jliklik/bcit_psu/Images/BCIT_PSU_CustomPCBs.jpg

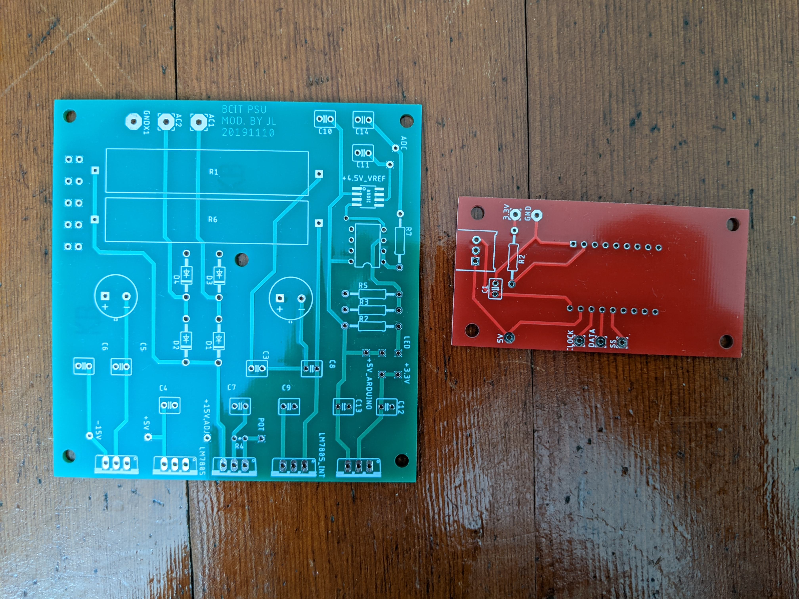
Images/BCIT_PSU_CustomPCBs.jpg
