jliklik/bcit_psu/Images/BCIT_PSU.jpg

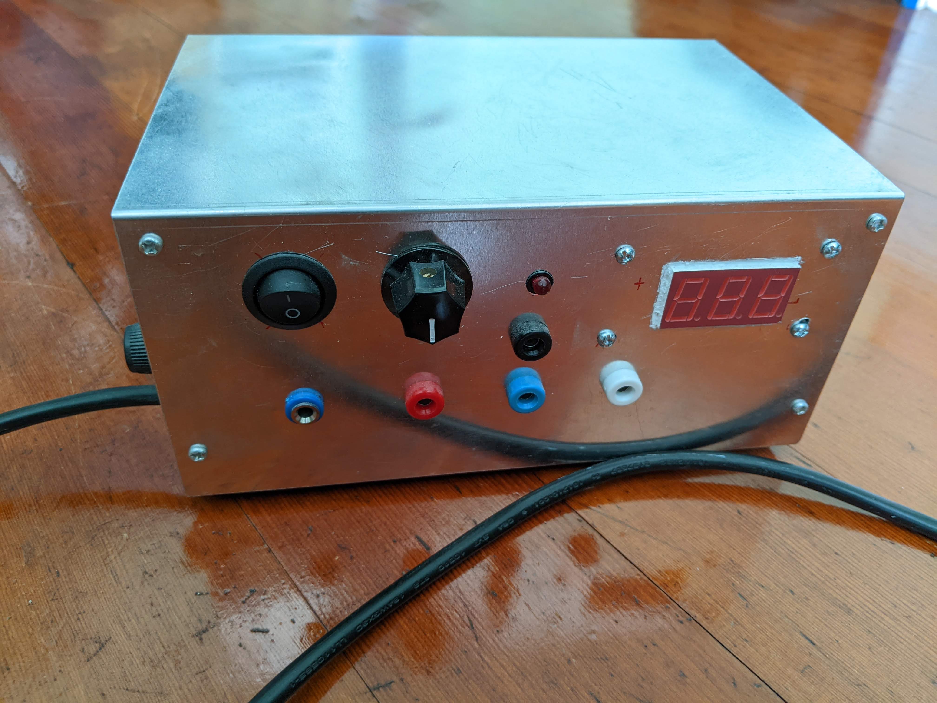
Images/BCIT_PSU.jpg
