jliklik/bcit_psu/LEDDisplay_Schematic.pdf

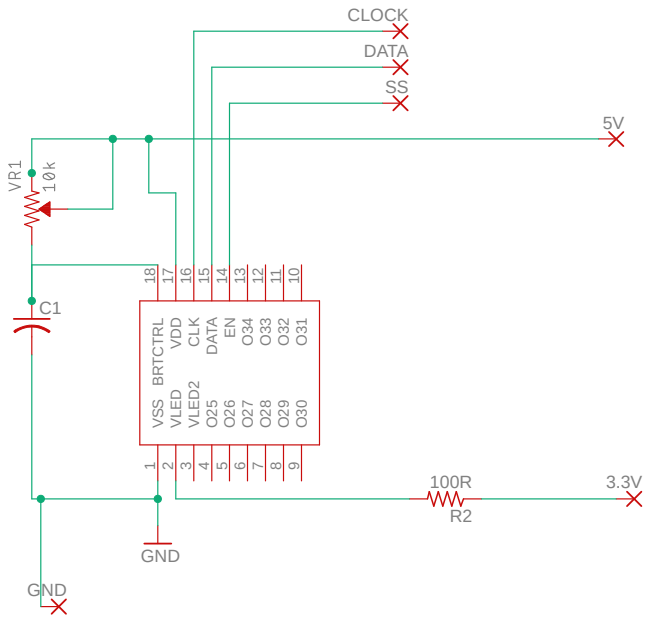
[picture p3: figure]
GND; 100R VSS; 1 VLED; 2 VLED2; CLOCK; DATA

2020-06-14 4:20 PM C:\Users\jlikl\Documents\EAGLE\projects\LTM 8522HR Board\LTM8522HR.sch (Sheet: 1/1)

### 9 BRTCTRL 18 VDD 17 CLK 16 DATA 15 EN 14 O34 13 O33 12 O32 11 O31 10
