jliklik/bcit_psu/BCIT PSU Doc/04B-PCB Artwork.pdf

ELEX 1102 | Electronic Fabrication Tools and Techniques
Product: DC Power Supply | Author: Instructor
Revision: B | PCB Artwork

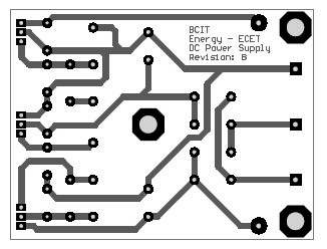
[picture p4: figure]

Date: 20160315 | Page: 1 of 1

Board dimensions: 3.30in x 2.50in
