jliklik/bcit_psu/Reference/ADC_circuit.png

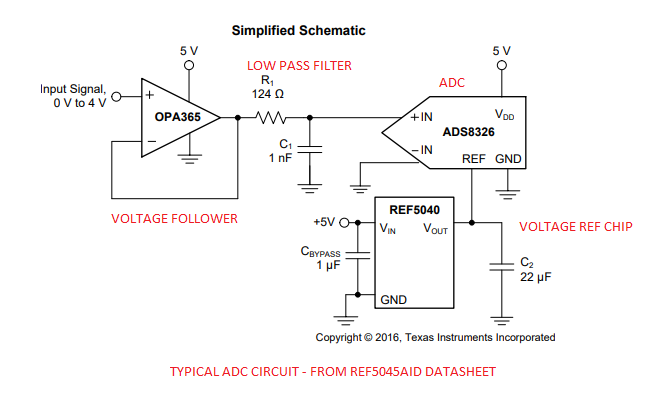
Reference/ADC_circuit.png
