jliklik/bcit_psu/BCIT PSU Doc/03B-Parts List.pdf

ELEX 1102 | Electronic Fabrication Tools and Techniques
Product: DC Power Supply | Author: Instructor
Revision: B | Parts List
Date: 20160602 | Page: 1 of 2

## Electrical

Ref Des | Description | Manufacturer | Part Number | Qty
C1,C2 | Capacitor, Al electrolytic, Radial, 3300uF, 20%, 25V | Nichicon | UVR1E332MHD (http://www.digikey.ca/product-search/en?keywords=493-1067-nd) | 2
C3,C5 | Capacitor, Al electrolytic, Radial, 0.1uF, 20%, 50V | Nichicon | UVR1H0R1MDD (http://www.digikey.ca/product-search/en?keywords=493-1095-nd) | 2
C4,C6 | Capacitor, Al electrolytic, Radial, 1uF, 20%, 50V | Nichicon | UVR1H010MDD (http://www.digikey.ca/product-search/en?keywords=493-1099-nd) | 2
C7 | Capacitor, Al electrolytic, Radial, 2.2uF, 20%, 50V | Nichicon | UVR1H2R2MDD (http://www.digikey.ca/product-search/en?keywords=493-1100-nd) | 1
D1,D2,D3,D4 | Diode, General purpose, DO41, 600V, 1A | Fairchild Semiconductor | 1N4005 (http://www.digikey.ca/product-search/en?keywords=1N4005FSCT-ND) | 4
D5 | Diode, Light emitting, Red, Panel Mount, 2-pin | Mode Electronics | 55-432-0 (https://www.e-sonic.com/Search.aspx?text=:%2055-432-0) | 1
F1 | Fuse, Glass, Miniature, Slow Blow, 250V, 0.375A | Bussman / Eaton | MDL-3/8 (https://www.e-sonic.com/product-detail/bussmann-eaton/mdl38.html?p=10812346) | 1
J1 | Connector, Banana, Red, Panel Mount, Solder Lug | Johnson | 108-0902-001 (https://www.e-sonic.com/product-detail/johnson-cinch-connectivity-solutions/1080902001.html?p=11276257) | 1
J2 | Connector, Banana, White, Panel Mount, Solder Lug | Johnson | 108-0901-001 (https://www.e-sonic.com/product-detail/johnson-cinch-connectivity-solutions/1080901001.html?p=11276256) | 1
J3 | Connector, Banana, Violet, Panel Mount, Solder Lug | Johnson | 108-0912-001 (https://www.e-sonic.com/product-detail/johnson-cinch-connectivity-solutions/1080912001.html?p=11276265) | 1
J4 | Connector, Banana, Black, Panel Mount, Solder Lug | Johnson | 108-0903-001 (https://www.e-sonic.com/product-detail/johnson-cinch-connectivity-solutions/1080903001.html?p=11276258) | 1
P1 | Power cord, 18AWG x 3, 1.8m, 125V, 10A | Volex | 17237-8-B1 (https://www.e-sonic.com/product-detail/volex-power-cords/172378b1.html?p=10687852) | 1
R1 | Resistor, Axial, 10R, 5%, 10W | Ohmite | 20J10RE (http://www.digikey.ca/product-detail/en/20J10RE/20J10RE-ND/822925) | 1
R2,R4 | Resistor, Axial, Carbon Film, 390R, 5%, 0.25W | Stackpole Electronics | CF14JT390R (http://www.digikey.ca/product-search/en?keywords=CF14JT390RCT-ND) | 2
R3 | Potentiometer, Linear, 5K, 20%, 0.1W, Panel Mount, Solder Lug | Mode Electronics | 62-243-0 (https://www.e-sonic.com/product-detail/mode/622430.html?p=45319501) | 1
S1 | Switch, SPST, Round, Rocker, Quick Connect, 250V, 10A | Mode Electronics | 46-100J-0 (https://www.e-sonic.com/product-detail/mode/46100j0.html?p=45319367) | 1
T1 | Transformer, Single Primary, Center tapped, 33V, 1A | Hammond | 166J33 (http://www.e-sonic.com/product-detail/hammond-canada/166j33.html?p=45469764) | 1
VR1 | Regulator, Fixed, TO220-3, LM7805, 5V, 1A | Fairchild Semiconductor | LM7805ACT (http://www.digikey.ca/product-search/en?keywords=LM7805ACT-ND) | 1
VR2 | Regulator, Adjustable, TO220-3, LM317, 1.5A | Fairchild Semiconductor | LM317TFS-ND (http://www.digikey.ca/product-search/en?keywords=LM317TFS-ND) | 1
VR3 | Regulator, Fixed, TO220-3, LM7915, -15V, 1A | Fairchild Semiconductor | LM7915CT (http://www.digikey.ca/product-search/en?keywords=LM7915CTFS-ND) | 1
- Consumable items are not included

ELEX 1102 | Electronic Fabrication Tools and Techniques
Product: DC Power Supply | Author: Instructor
Revision: B | Parts List
Date: 20160602 | Page: 2 of 2

## Mechanical

Ref Des | Description | Manufacturer | Part Number | Qty
M1 | Board, Printed circuit, DC Power Supply, Rev B | Enigma Interconnect | DC Power Supply Rev B (http://www.enigmacorp.com/) | 1
M2 | Bushing, Strain relief, Black, Nylon | Essentra Components | SRB-R-5 (http://www.digikey.ca/product-search/en?keywords=RP465-nd) | 1
M3 | Enclosure, Custom, 3″D x 5″W x 4″H, Rev B, Aluminum | Bud Industries | 49239 (http://www.digikey.ca/) | 1
M4 – M7 | Feet, Leveling, ¹/4″H x ¹/2″D, Black, Adhesive, Rubber | Mode Electronics | 54-880-0 (https://www.e-sonic.com/product-detail/mode/548800.html?p=45318899) | 4
M8 | Holder, Fuse, 1/4″ x 1¹ /4″, Panel mount, 250V, 20A | Eaton | BK/HTB-241-R (http://www.digikey.ca/product-search/en?keywords=283-2711-ND) | 1
M9 – M11 | Insulator, TO220, Mica | Keystone Electronics | 4672 (http://www.digikey.ca/product-search/en?keywords=4672K-ND) | 3
M12 | Knob, ³/8″H x ⁷/8″D, Set screw | Mode Electronics | 54-217-0 (https://www.e-sonic.com/product-detail/mode/542170.html?p=45319179) | 1
M13 – M15 | Nut, Hex, #6-32, Nylon | N/A* | N/A (http://www.pacificfasteners.com/) | 3
M16 – M21 | Nut, Hex, #6-32, Steel | N/A* | N/A (http://www.pacificfasteners.com/) | 6**
M22 | Nut, Hex, #8-32, Steel | N/A* | N/A (http://www.pacificfasteners.com/) | 1
M23 – M25 | Screw, Bind, Slot, #6-32, ¹/2″, Nylon | N/A* | N/A (http://www.pacificfasteners.com/) | 3
M26 – M28 | Screw, Round, Robertson #1, #6-32, ¹/2″, Steel | N/A* | N/A (http://www.pacificfasteners.com/) | 3**
M29 – M31 | Screw, Round, Robertson #1, #6-32, 1″, Steel | N/A* | N/A (http://www.pacificfasteners.com/) | 3
M32 | Screw, Round, Robertson #2, #8-32, ¹/2″, Steel | N/A* | N/A (http://www.pacificfasteners.com/) | 1
M33 – M35 | Spacer, #6 x ³/8″H x ¹/4″D, Aluminum | N/A* | N/A (http://www.pacificfasteners.com/) | 3
M36, M37 | Terminal, Quick Connect, Female, 22 – 18 AWG, Crimp | Mode Electronics | 73-334-0 (https://www.e-sonic.com/product-detail/mode/733340.html?p=45318831) | 2
M38 | Terminal, Ring Tongue, 22 – 16 AWG, Crimp | Panduit | P18-8R-C (https://www.e-sonic.com/product-detail/panduit-canada/p188rc.html?p=45622594) | 1
M39 – M53 | Tie, Cable, 3¹/8″, Nylon | Panduit | PLT.7M-M (http://www.digikey.ca/product-detail/en/panduit-corp/PLT.7M-M/298-1019-ND/280032) | 15
M54 | Tube, Heatshrink, 4″H x ³ /16″D, Black, Polyolefin | Alpha Wire | F221B3/16 BK100 (http://www.digikey.ca/product-detail/en/alpha-wire/F221B3-16-BK100/A316B-4-ND/281673) | 1
M55 – M60 | Washer, Flat, #6, Steel | N/A* | N/A (http://www.pacificfasteners.com/) | 6
M61 – M65 | Washer, Split, #6, Steel | N/A* | N/A (http://www.pacificfasteners.com/) | 5
M66 | Washer, Split, #8, Steel | N/A* | N/A (http://www.pacificfasteners.com/) | 1
M67 | Washer, Star, #8, External, Steel | N/A* | N/A (http://www.pacificfasteners.com/) | 1
M68 | Washer, Star, ¹/4″, Internal, Steel | N/A* | N/A (http://www.pacificfasteners.com/) | 1
- Consumable items are not included | * Suggested supplier: Pacific Fasteners | ** Includes 1 spare
