jliklik/bcit_psu/BCIT PSU Doc/01C-Master Build List.pdf

ELEX 1102 | Electronic Fabrication Tools and Techniques
Product: DC Power Supply | Author: Instructor
Revision: C | Master Build List
Date: 20170314 | Page: 1 of 1
© 2016 – 2017 M. LeNoble

Product Description
The DC Power Supply provides three DC voltage outputs when powered by a 120VAC, 60Hz source. The rated DC output voltages are +5VDC (fixed), -15VDC (fixed) and +15VDC (variable). The rated current at each output is 1A.
Change Log
Revision | Change Description
C | Incorporated Alignment Jig
B | Revised documents
A | Initial product release

Product Documents
Document Title | e-File Name | Revision
Master Build List | 01C-Master Build List | C
Schematic Diagram | 02D-Schematic Diagram | D
Parts List | 03B-Parts List | B
PCB Artwork | 04B-PCB Artwork | B
Component Locator | 05C-Component Locator | C
Alignment Test | 06-1B-Alignment Test | B
Acceptance Test | 06-2C-Acceptance Test | C
Plan View – Chassis | 07-1B-Plan View | B
Interconnect Wiring | 07-2B-Interconnect Wiring | B
