jliklik/bcit_psu/LEDDisplay_PCB.pdf

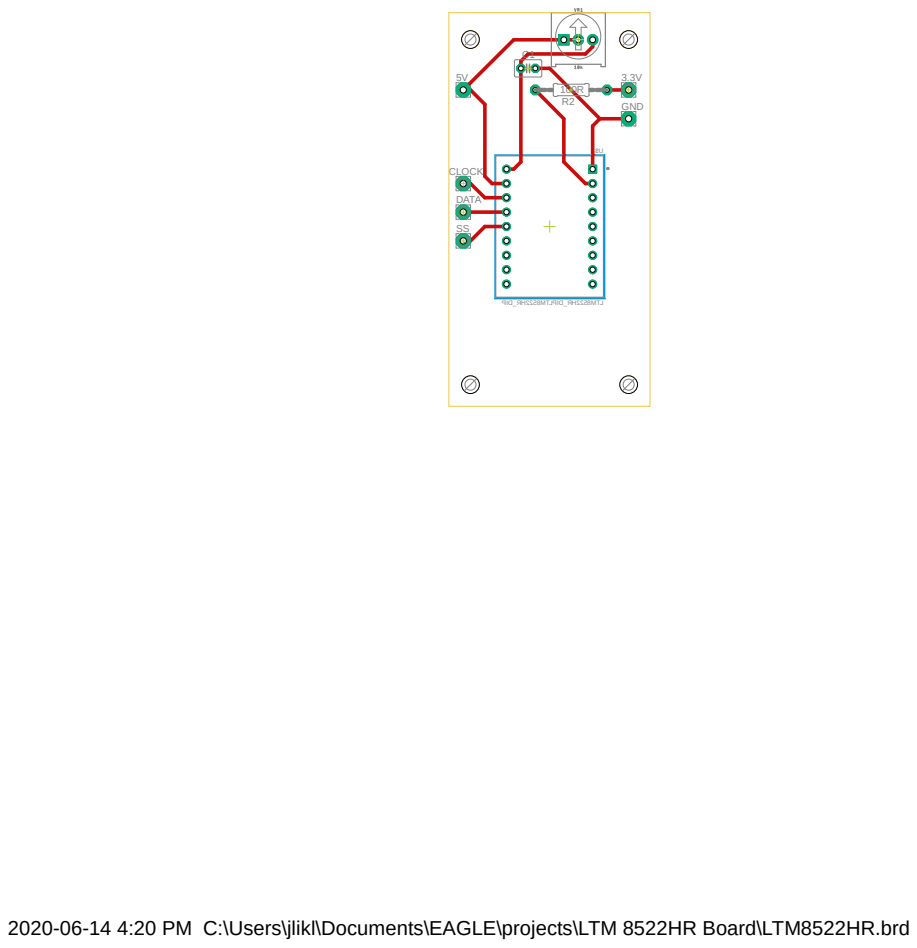
[picture p9: page 1]
C1 CLOCK DATA; GND

2020-06-14 4:20 PM C:\Users\jlikl\Documents\EAGLE\projects\LTM 8522HR Board\LTM8522HR.brd
