jliklik/bcit_psu/PCB_20191226_LTM8522HR_v1.pdf

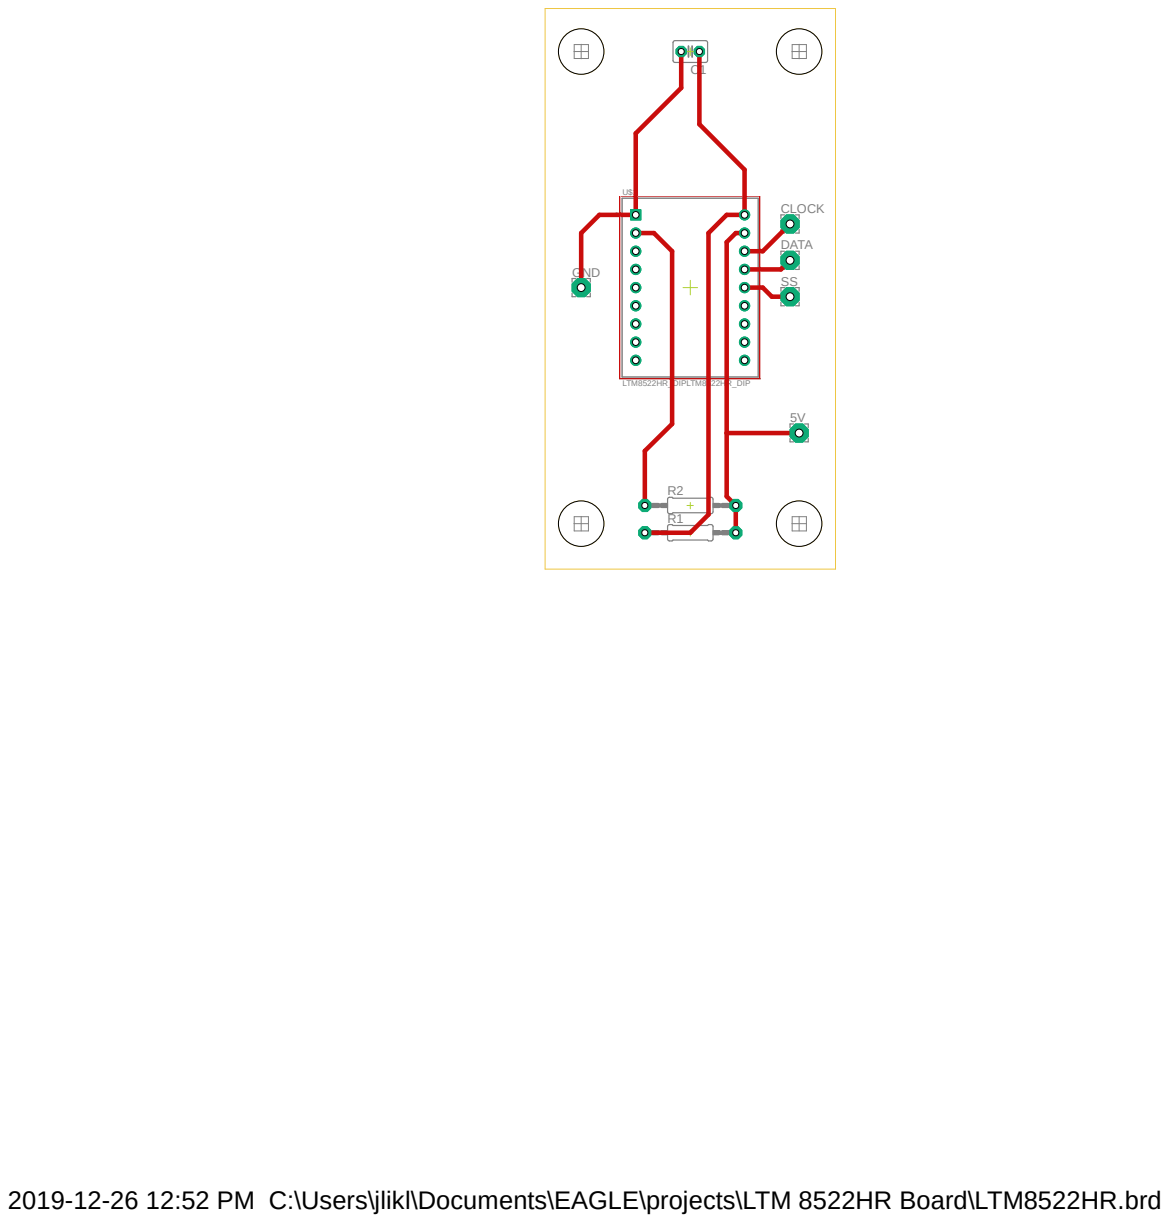
[picture p10: page 1]
CLOCK DATA R1 R2; SS U$1 GND; LTM8522HR_DIPLTM8522HR_DIP

2019-12-26 12:52 PM C:\Users\jlikl\Documents\EAGLE\projects\LTM 8522HR Board\LTM8522HR.brd
