jliklik/bcit_psu/PCB_20191226_v1.pdf

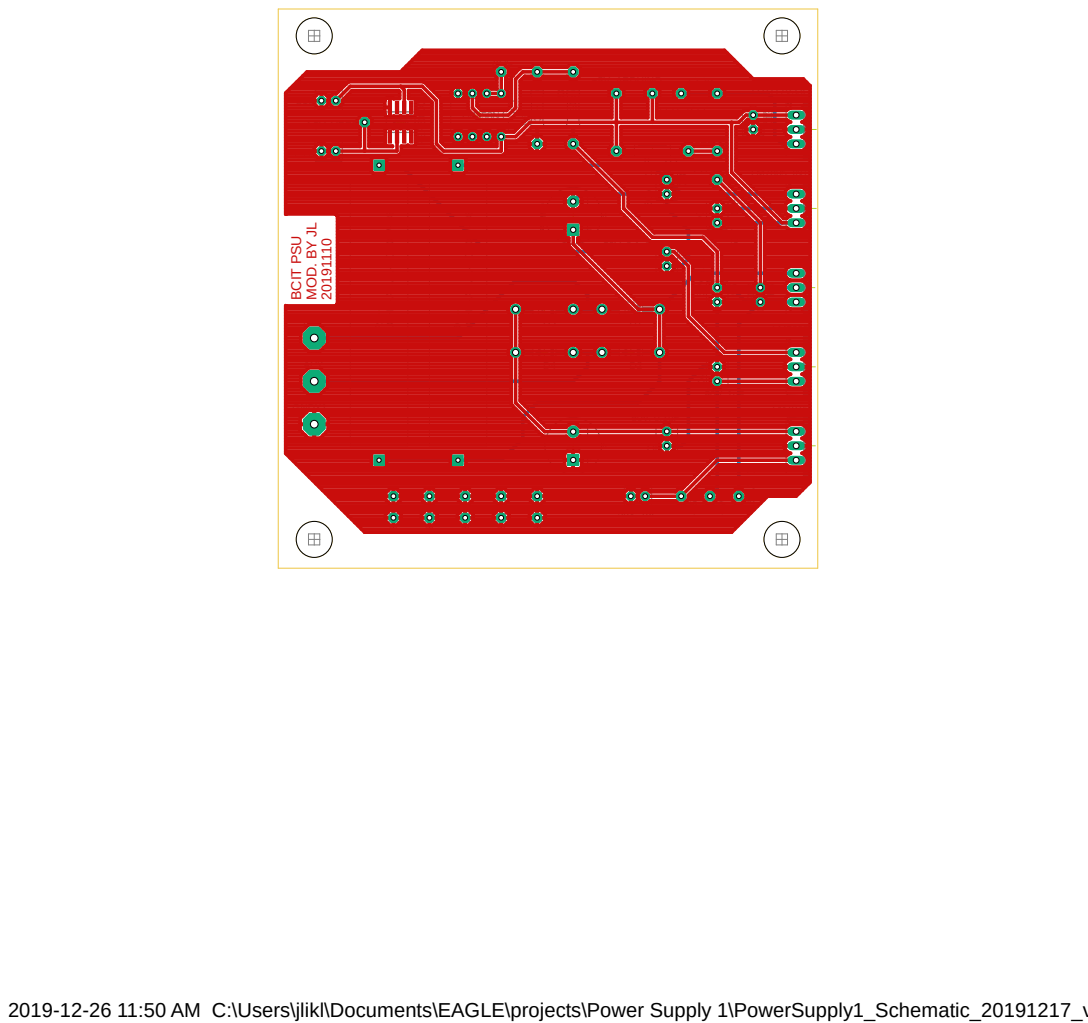
[picture p11: page 1]

2019-12-26 11:50 AM C:\Users\jlikl\Documents\EAGLE\projects\Power Supply 1\PowerSupply1_Schematic_20191217_v2_GroundPlane.brd REF50XX

LM358N BCIT PSU MOD. BY JL 20191110

REF50XX

LED_7SEG
