jliklik/bcit_psu/PCB_LED_20191229_v1.pdf

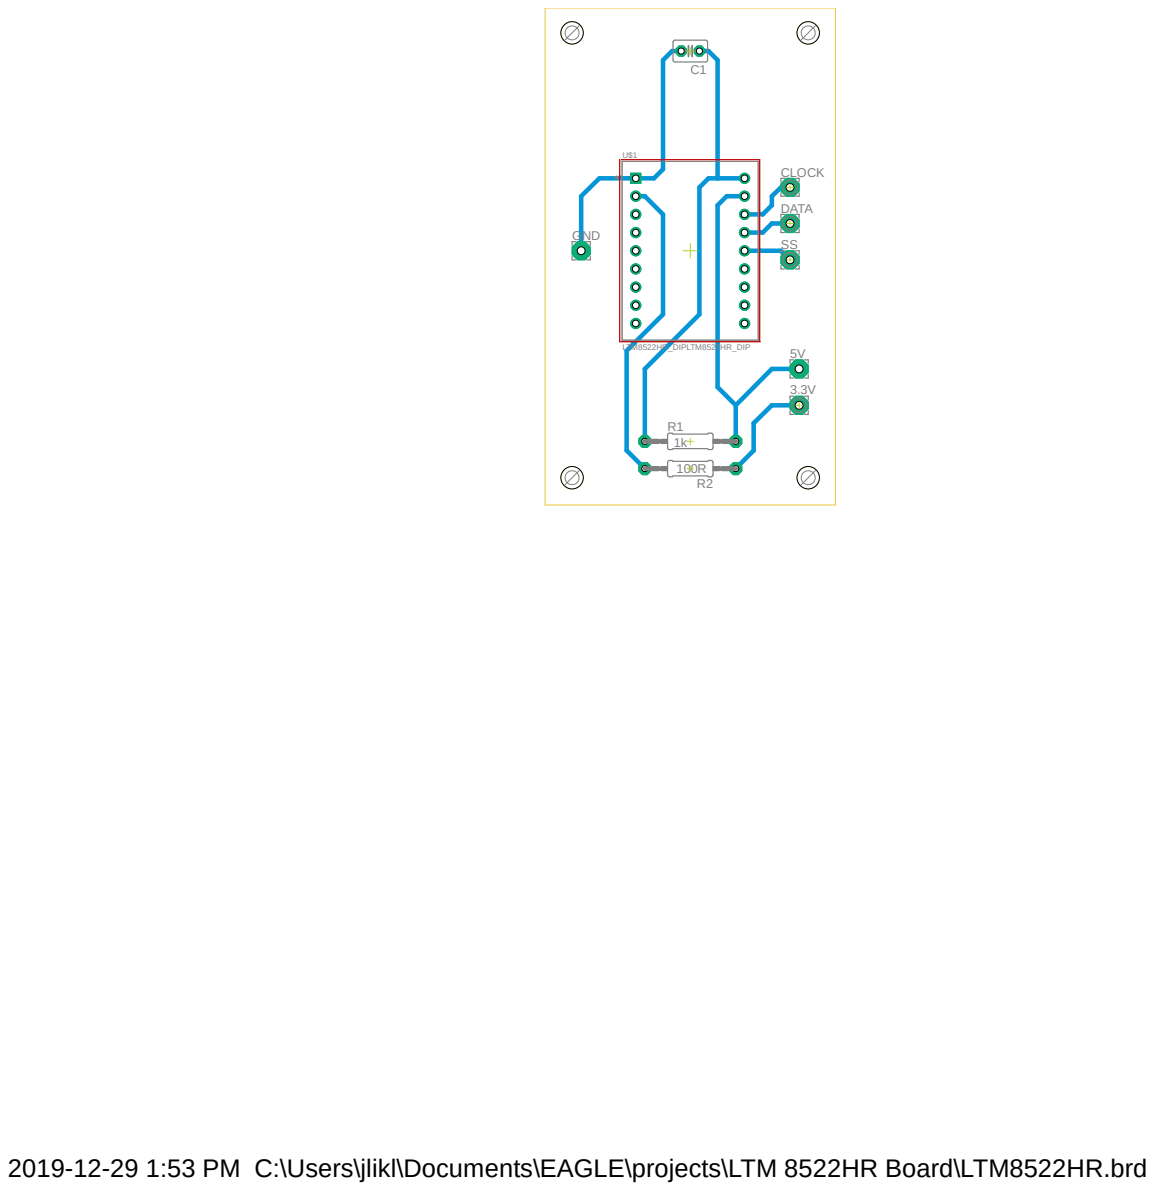
[picture p12: page 1]
CLOCK DATA R1 R2; SS U$1 GND; LTM8522HR_DIPLTM8522HR_DIP

2019-12-29 1:53 PM C:\Users\jlikl\Documents\EAGLE\projects\LTM 8522HR Board\LTM8522HR.brd
