jliklik/bcit_psu/PCB_LED_20200101_v1.pdf

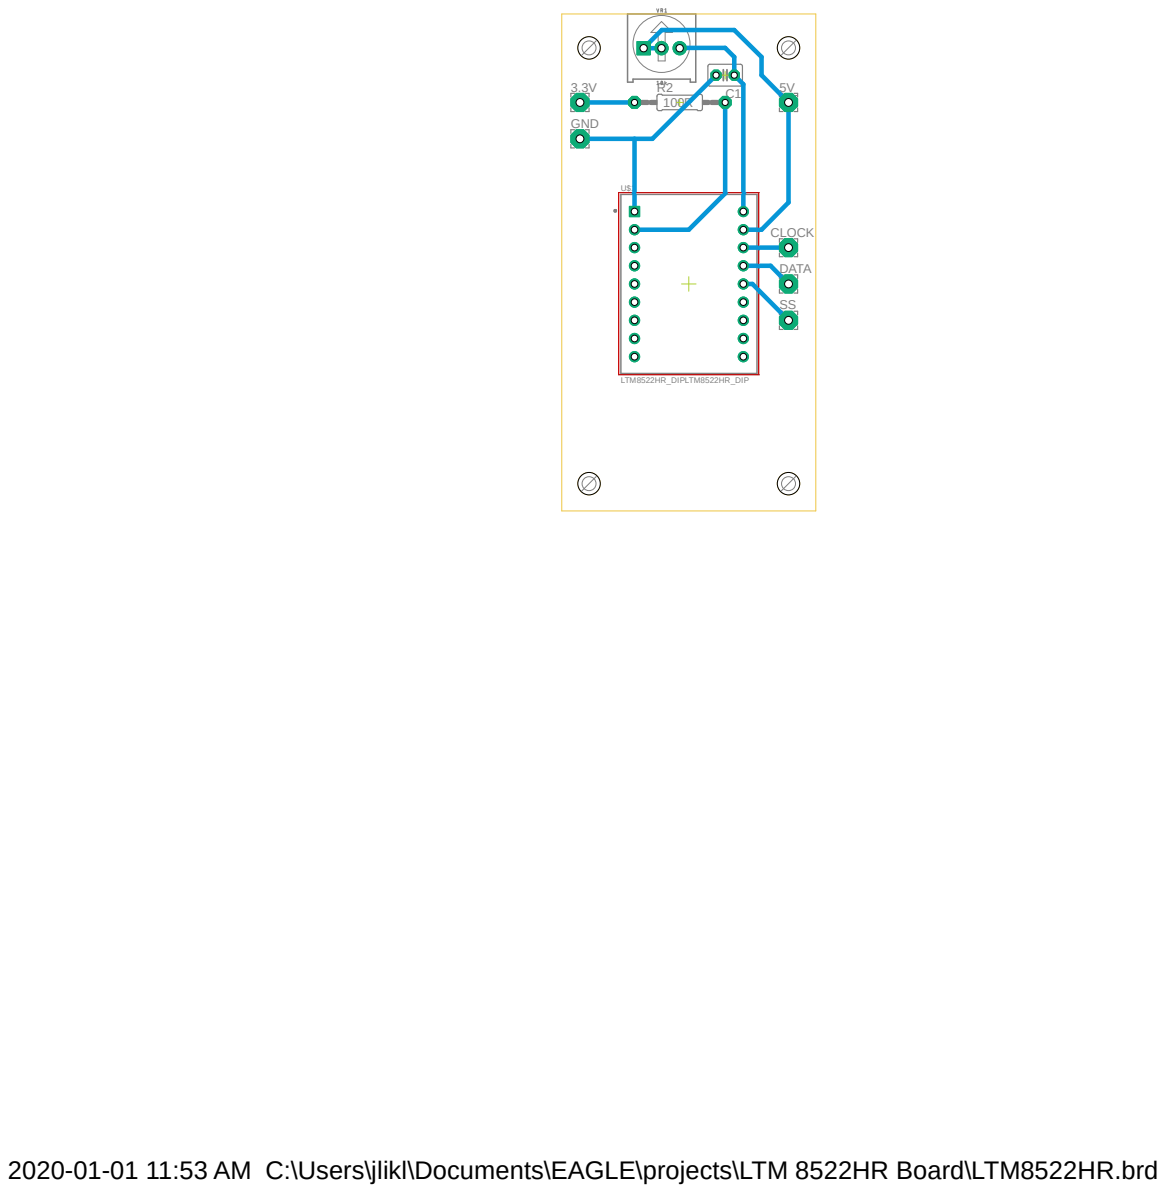
[picture p13: page 1]
CLOCK DATA R2; SS U$1 GND; LTM8522HR_DIPLTM8522HR_DIP

2020-01-01 11:53 AM C:\Users\jlikl\Documents\EAGLE\projects\LTM 8522HR Board\LTM8522HR.brd
