jliklik/bcit_psu/PCB_PSU_20191229_v1.pdf

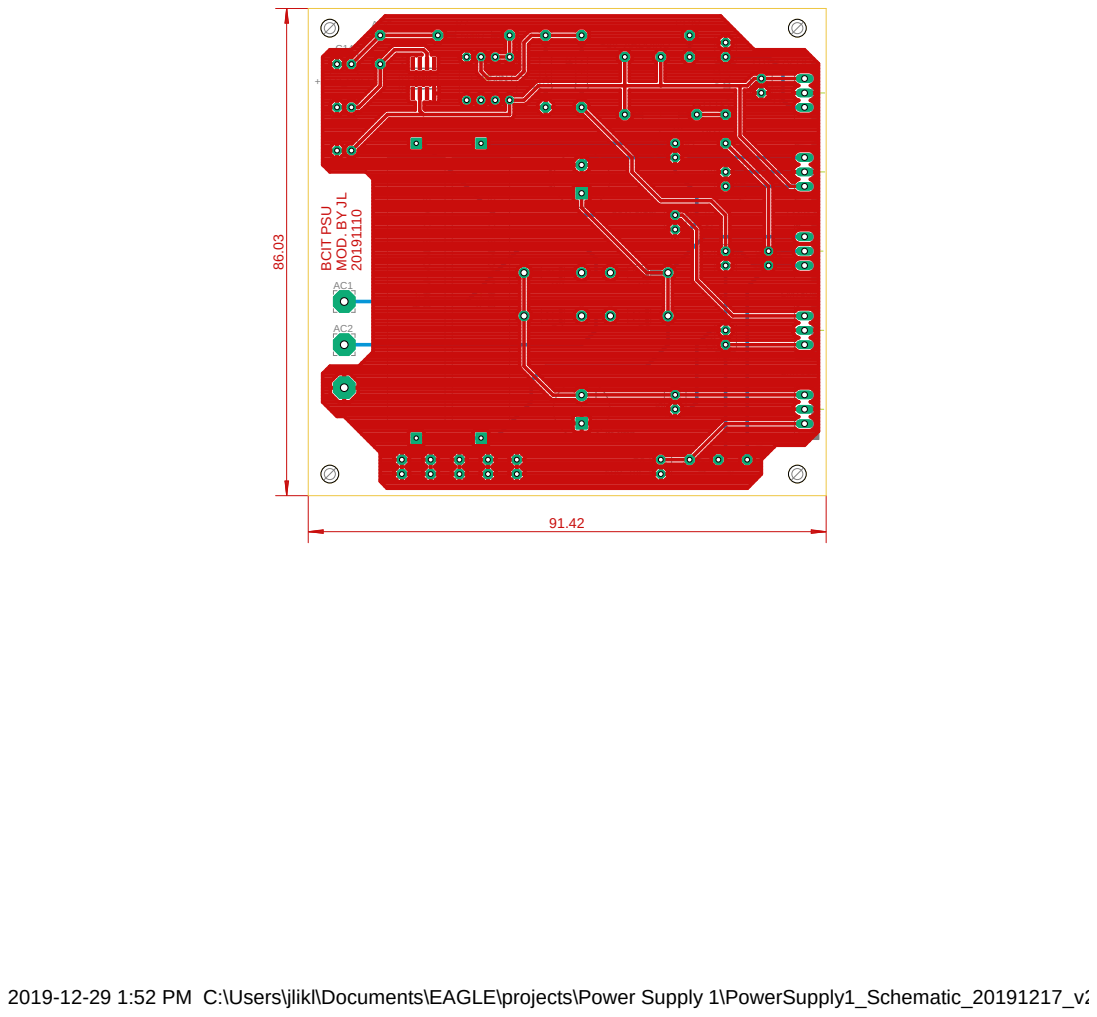
[picture p14: page 1]

2019-12-29 1:52 PM C:\Users\jlikl\Documents\EAGLE\projects\Power Supply 1\PowerSupply1_Schematic_20191217_v2_GroundPlane.brd REF50XX
