jliklik/bcit_psu/PCB_PSU_20200101_v1.pdf

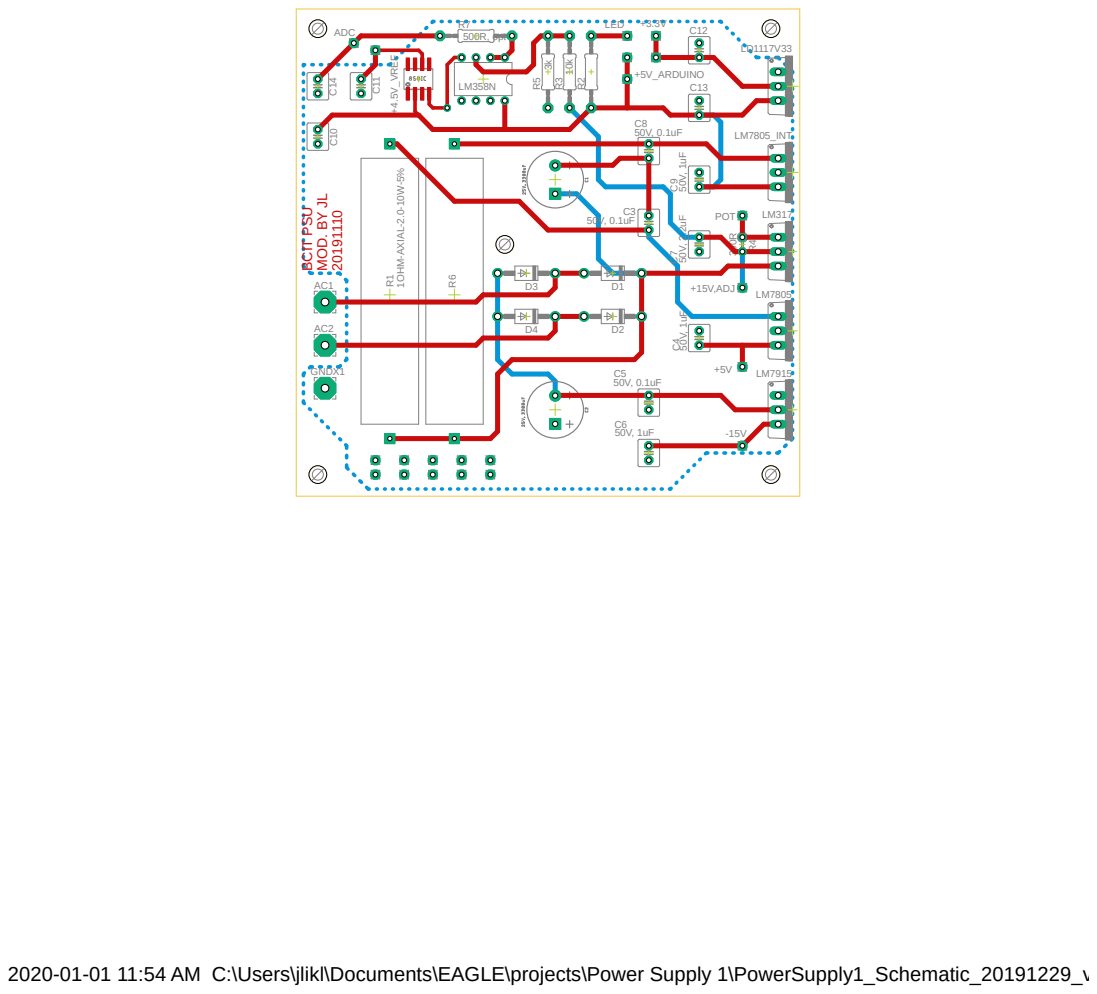
[picture p15: page 1]

LM7915 BCIT PSU MOD. BY JL 20191110

2020-01-01 11:54 AM C:\Users\jlikl\Documents\EAGLE\projects\Power Supply 1\PowerSupply1_Schematic_20191229_v1.brd
