jliklik/bcit_psu/PowerSupplyBoard_PCB.pdf

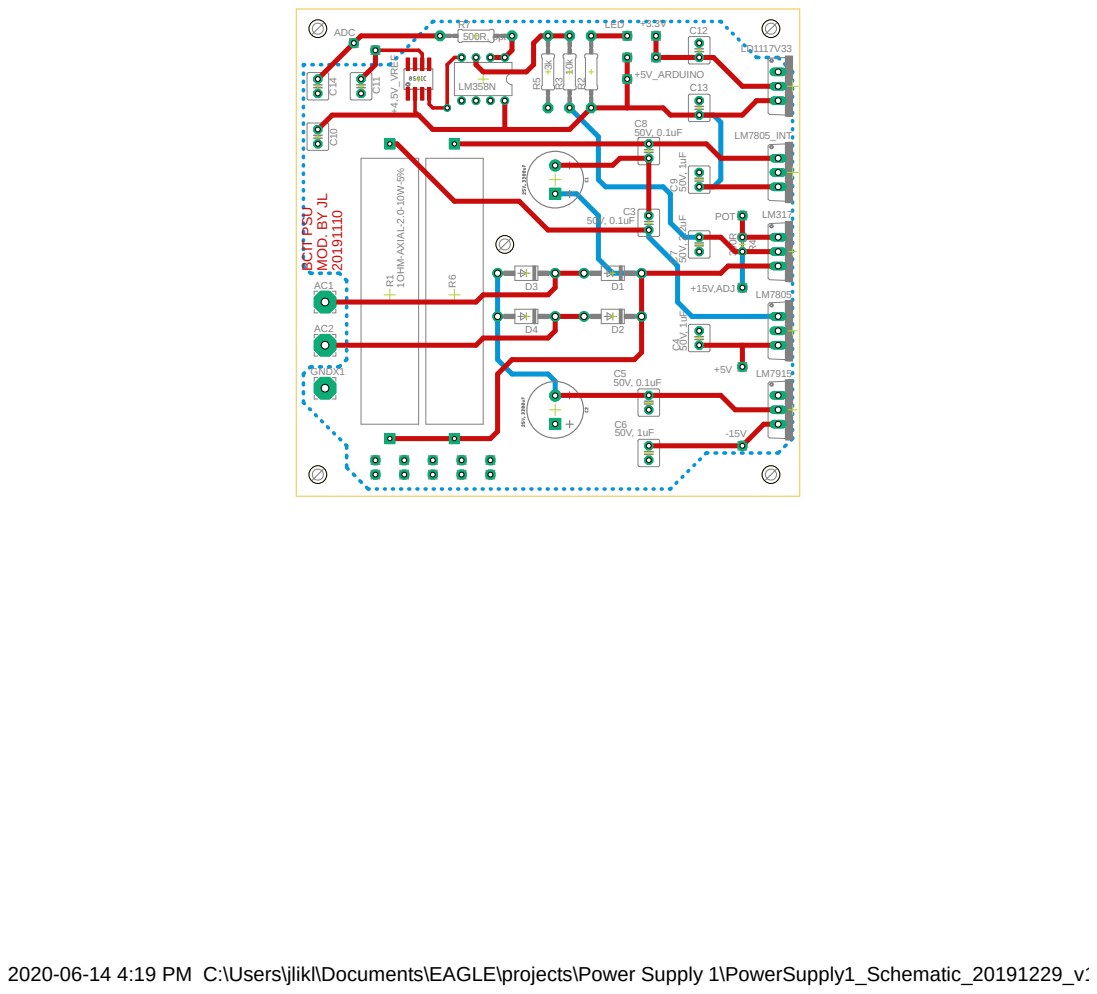
[picture p16: page 1]

LM7915 BCIT PSU MOD. BY JL 20191110

2020-06-14 4:19 PM C:\Users\jlikl\Documents\EAGLE\projects\Power Supply 1\PowerSupply1_Schematic_20191229_v1.brd
