jliklik/bcit_psu/PowerSupplyBoard_Schematic.pdf

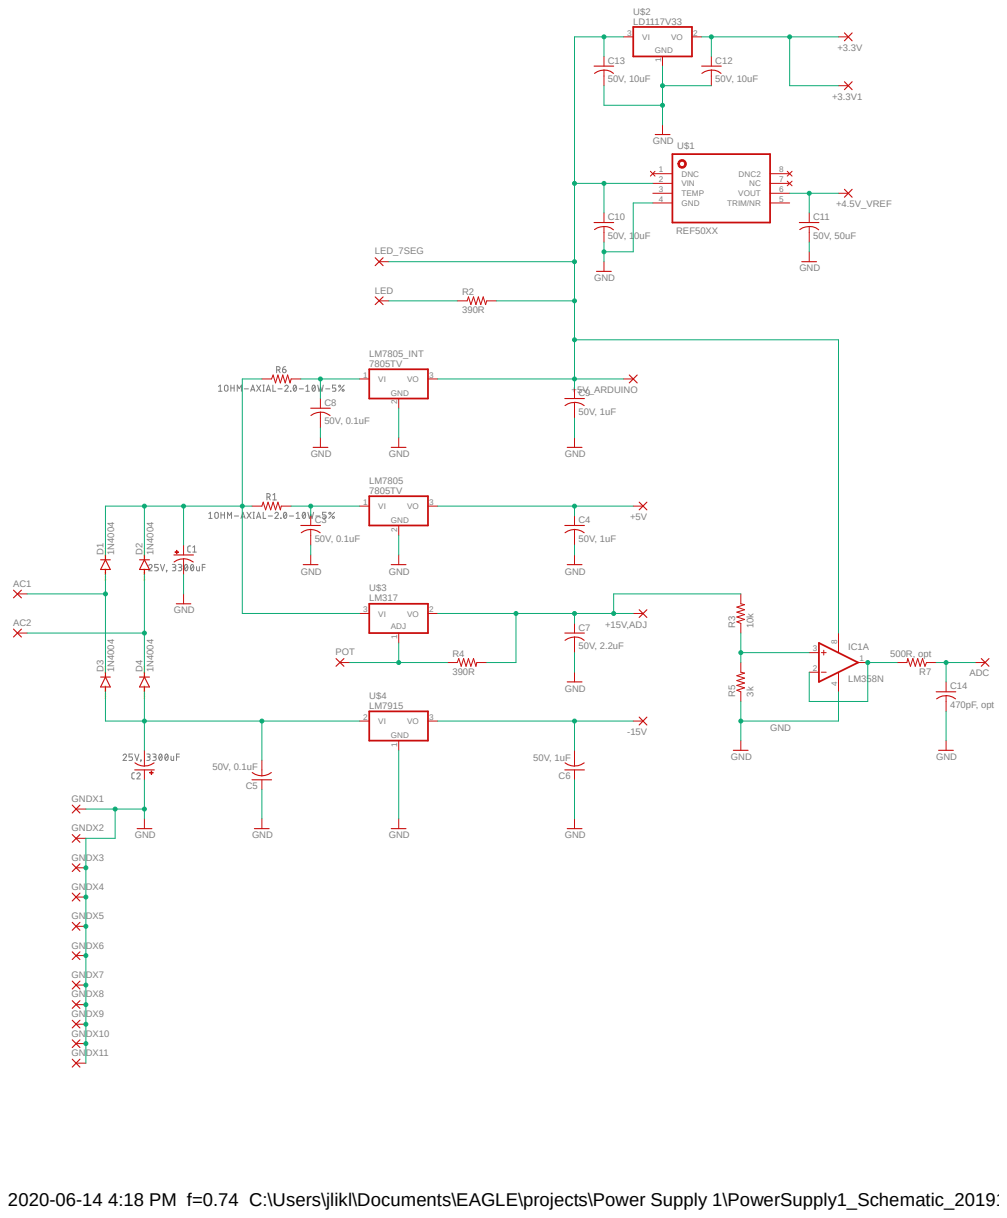
[picture p17: page 1]
