jliklik/bcit_psu/BCIT PSU Doc/02D-Schematic Diagram.pdf

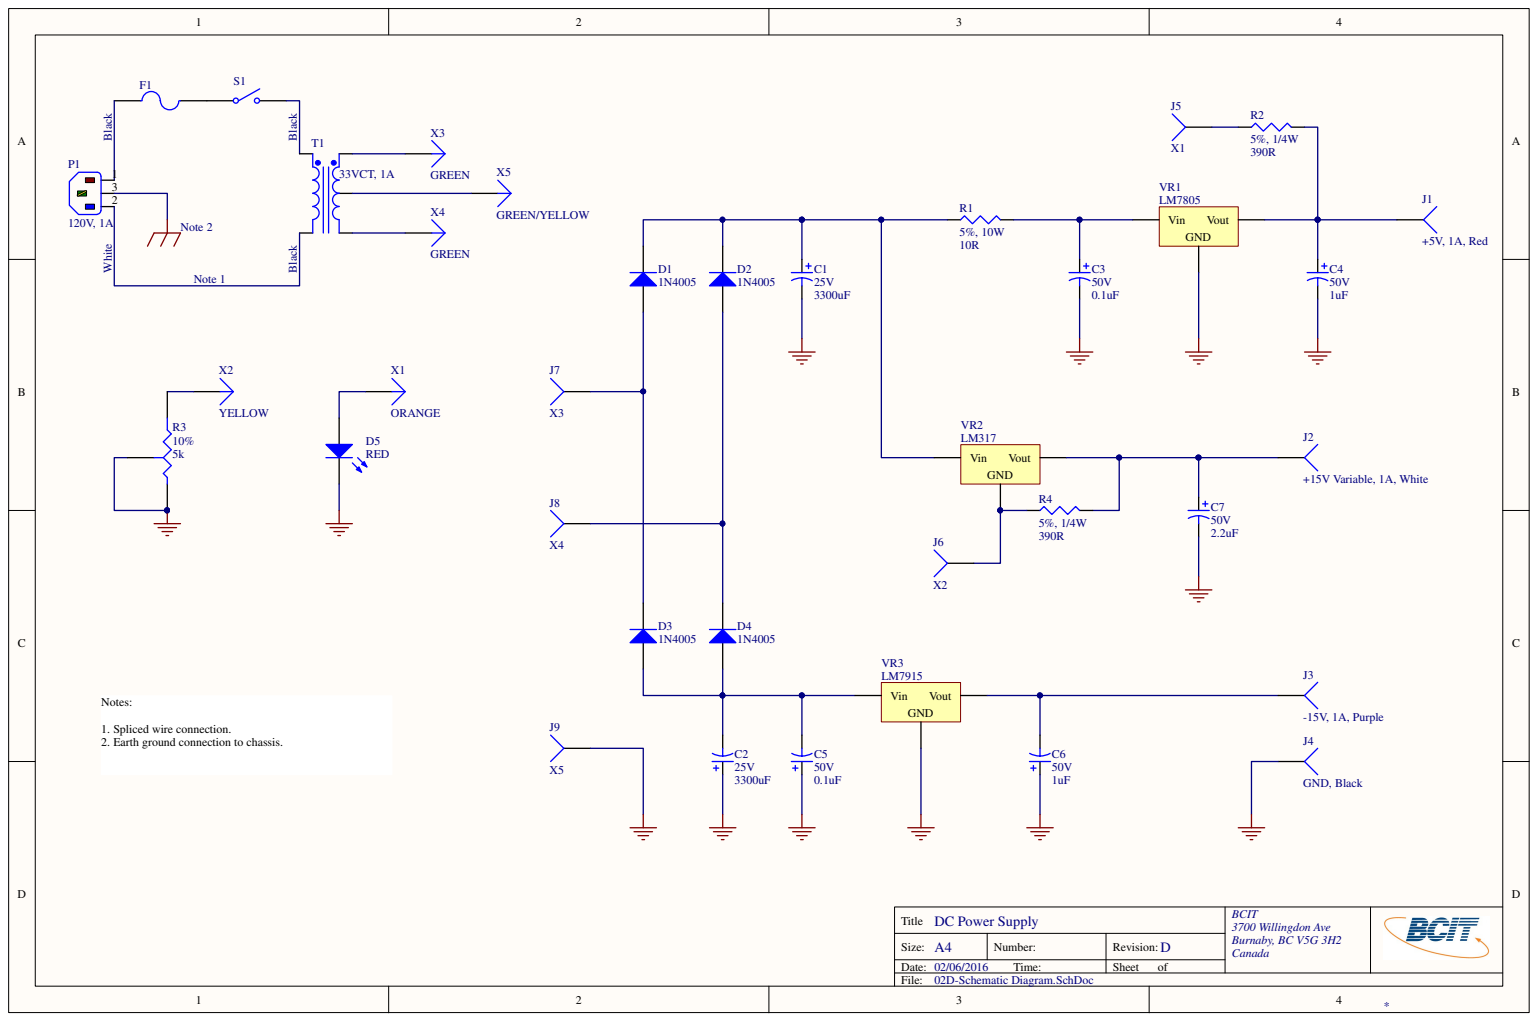
[picture p18: page 1]
