jliklik/bcit_psu/BCIT PSU Doc/07-2B-Interconnect.pdf

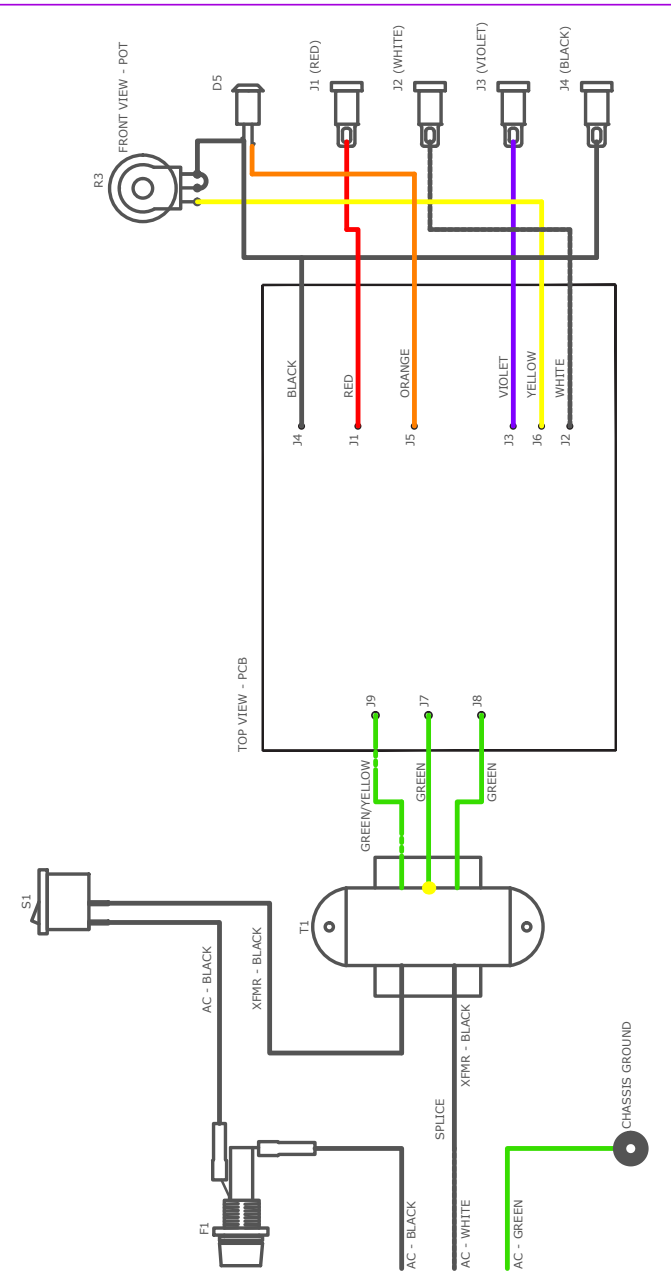
[picture p19: page 1]

C- APPR. BY DATE AS BUILT

AC - WHITE XFMR - BLACK
